jefreyhipp/Dispositivo_de_asistencia_para_personas_con_baja_vision/Ensamble Final/im1.jpg

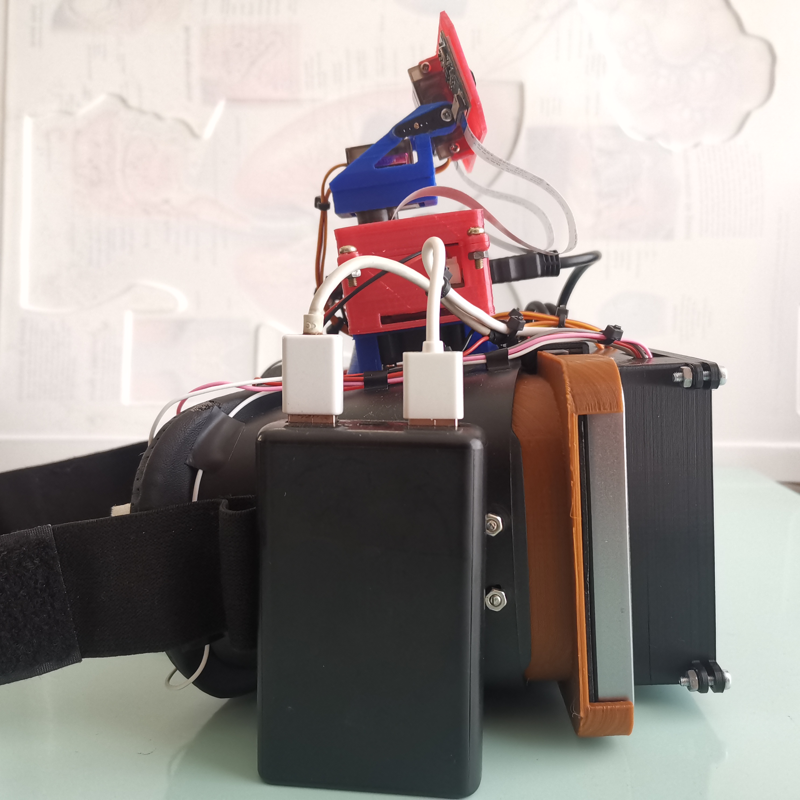
Ensamble Final/im1.jpg
