jefreyhipp/Dispositivo_de_asistencia_para_personas_con_baja_vision/Diseños 3D/Renders/pieza1,2.png

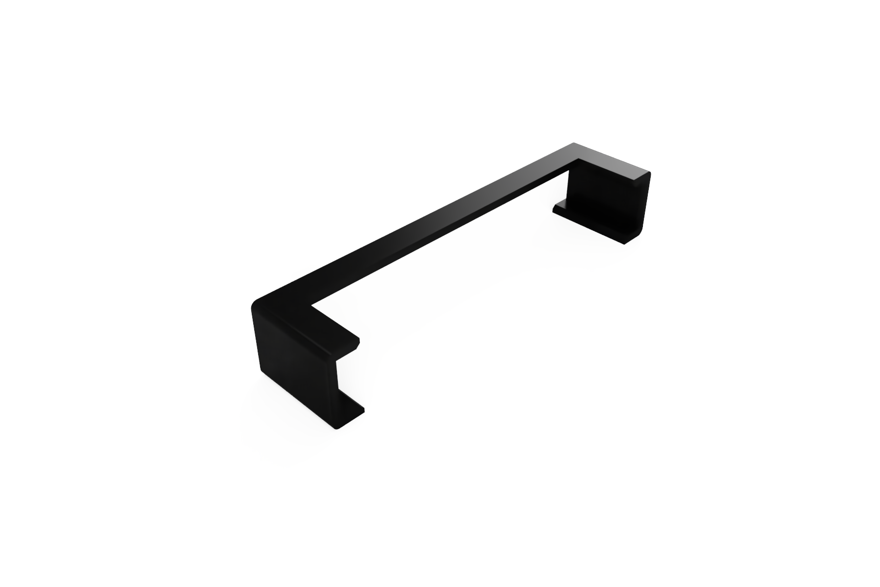
Diseños 3D/Renders/pieza1,2.png
