jefreyhipp/Dispositivo_de_asistencia_para_personas_con_baja_vision/Diseños 3D/Archivos STL/pieza4.stl

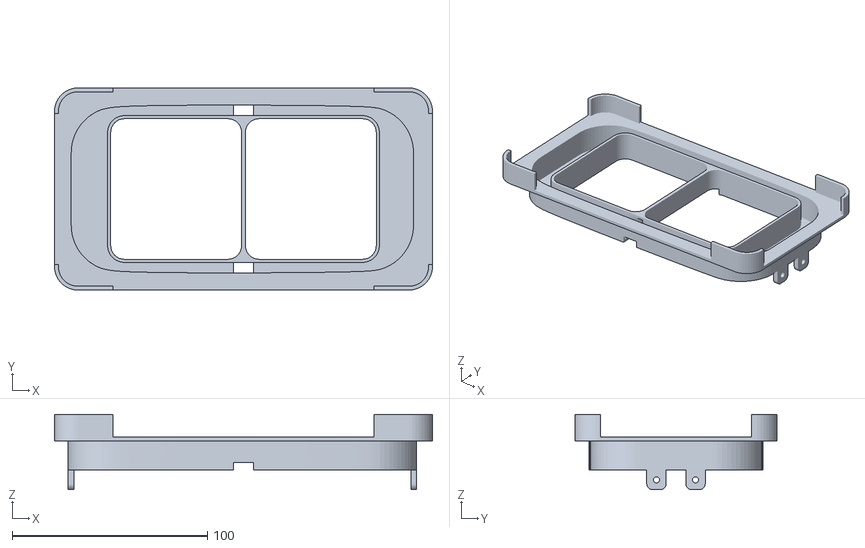
[picture p13: CAD file, 2021-05-15]
Diseños 3D/Archivos STL/pieza4.stl
193.6 x 103.6 x 38.6
