jefreyhipp/Dispositivo_de_asistencia_para_personas_con_baja_vision/Diseños 3D/Archivos STL/pieza6.stl

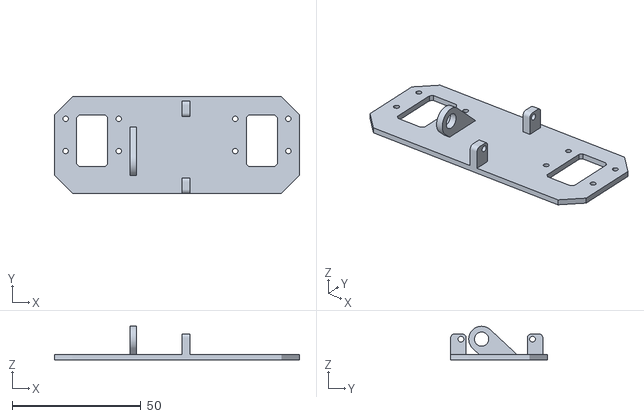
[picture p14: CAD file, 2021-05-15]
Diseños 3D/Archivos STL/pieza6.stl
95.0 x 37.5 x 13.0
