jefreyhipp/Dispositivo_de_asistencia_para_personas_con_baja_vision/Diseños 3D/Archivos STL/pieza10.stl

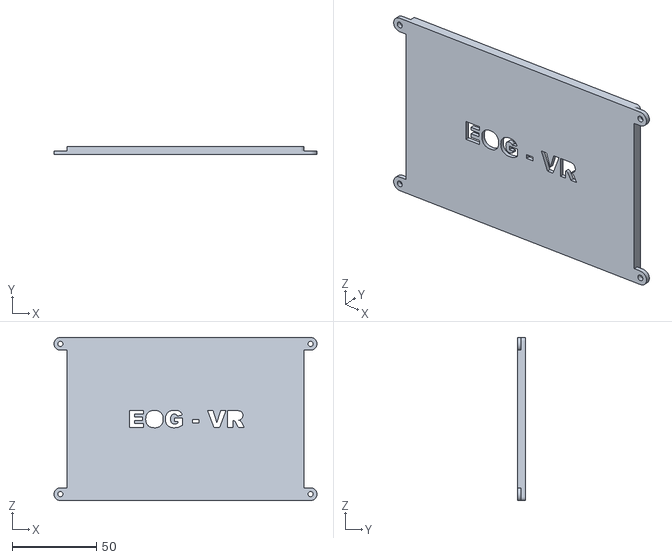
[picture p15: CAD file, 2021-05-15]
Diseños 3D/Archivos STL/pieza10.stl
155.7 x 5.00 x 96.6
