jefreyhipp/Dispositivo_de_asistencia_para_personas_con_baja_vision/Diseños 3D/Archivos STL/pieza9.stl

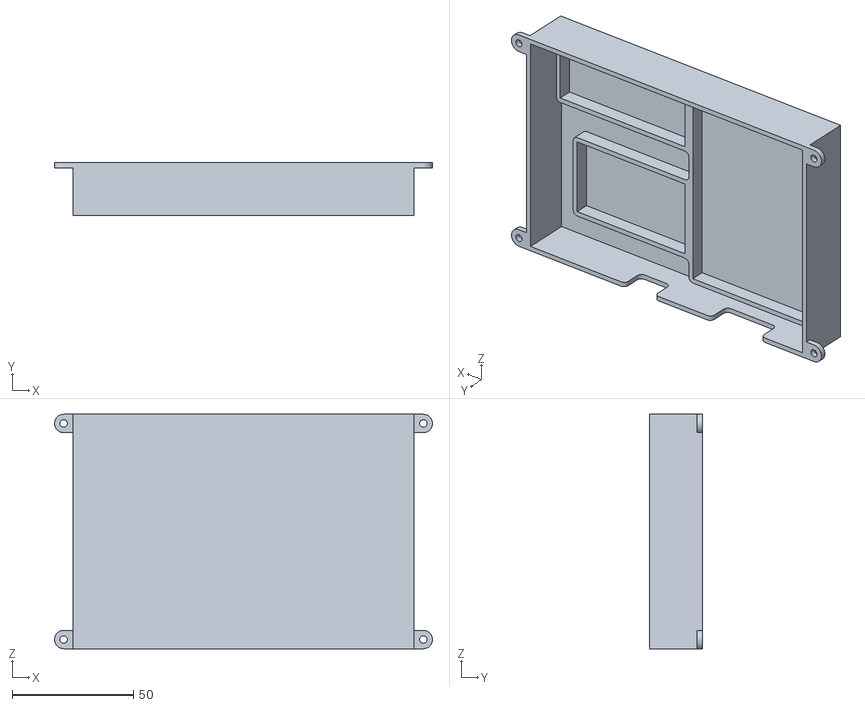
[picture p16: CAD file, 2021-05-15]
Diseños 3D/Archivos STL/pieza9.stl
155.7 x 22.0 x 96.6
