jefreyhipp/Dispositivo_de_asistencia_para_personas_con_baja_vision/Diseños 3D/Archivos STL/pieza5.stl

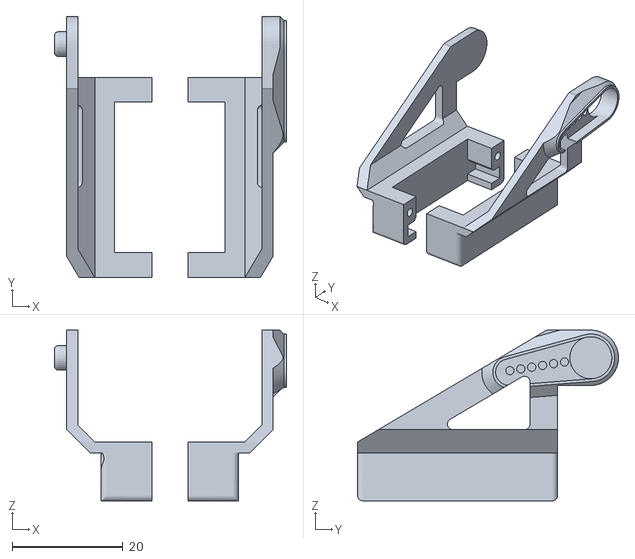
[picture p17: CAD file, 2021-05-15]
Diseños 3D/Archivos STL/pieza5.stl
42.0 x 47.2 x 30.9
