jefreyhipp/Dispositivo_de_asistencia_para_personas_con_baja_vision/Diseños 3D/Archivos STL/pieza7.stl

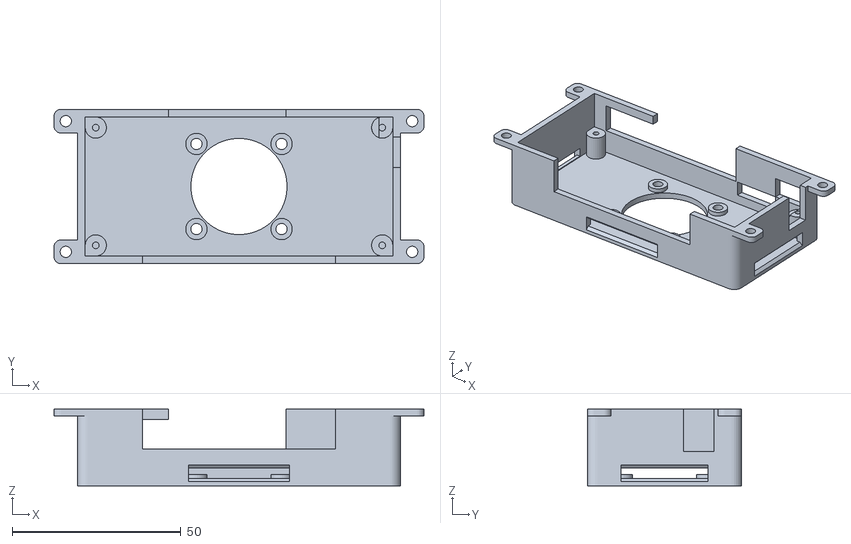
[picture p18: CAD file, 2021-05-15]
Diseños 3D/Archivos STL/pieza7.stl
109.7 x 45.8 x 22.8
