jefreyhipp/Dispositivo_de_asistencia_para_personas_con_baja_vision/Diseños 3D/Archivos STL/pieza8.stl

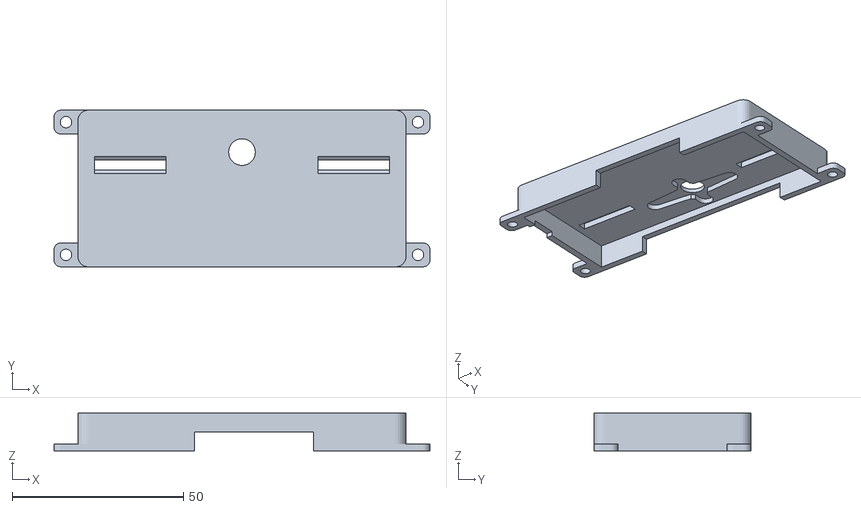
[picture p19: CAD file, 2021-05-15]
Diseños 3D/Archivos STL/pieza8.stl
109.8 x 45.8 x 11.0
