jefreyhipp/Dispositivo_de_asistencia_para_personas_con_baja_vision/Diseños 3D/Archivos STL/pieza1.stl

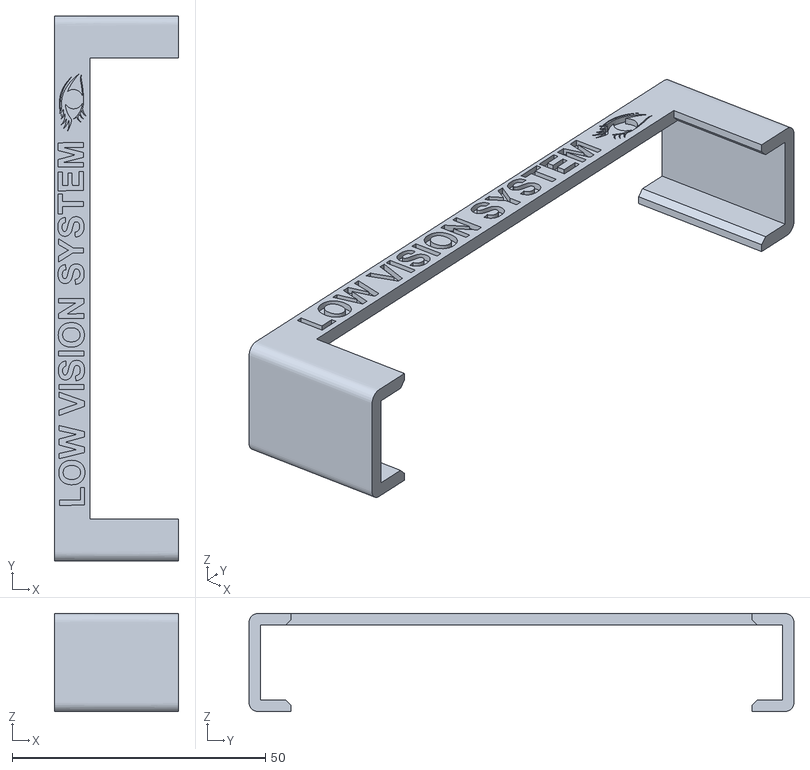
[picture p20: CAD file, 2021-05-15]
Diseños 3D/Archivos STL/pieza1.stl
24.5 x 107.6 x 19.4
