jefreyhipp/Dispositivo_de_asistencia_para_personas_con_baja_vision/Diseños 3D/Archivos STL/pieza3.stl

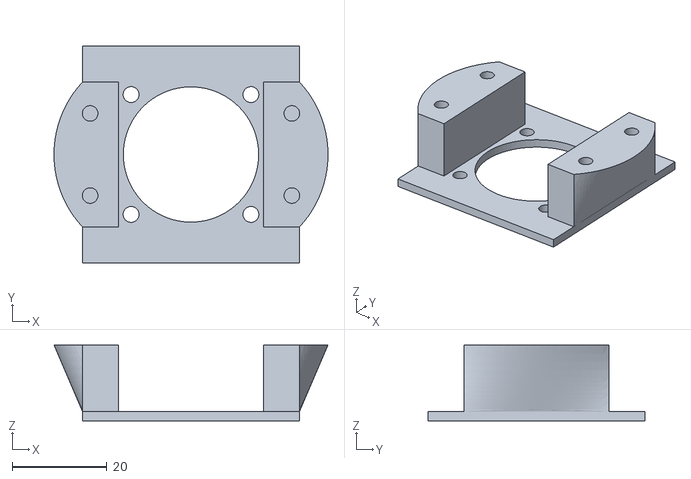
[picture p21: CAD file, 2021-05-15]
Diseños 3D/Archivos STL/pieza3.stl
57.7 x 45.8 x 16.0
