jefreyhipp/Dispositivo_de_asistencia_para_personas_con_baja_vision/Ensamble Final/im2.jpg

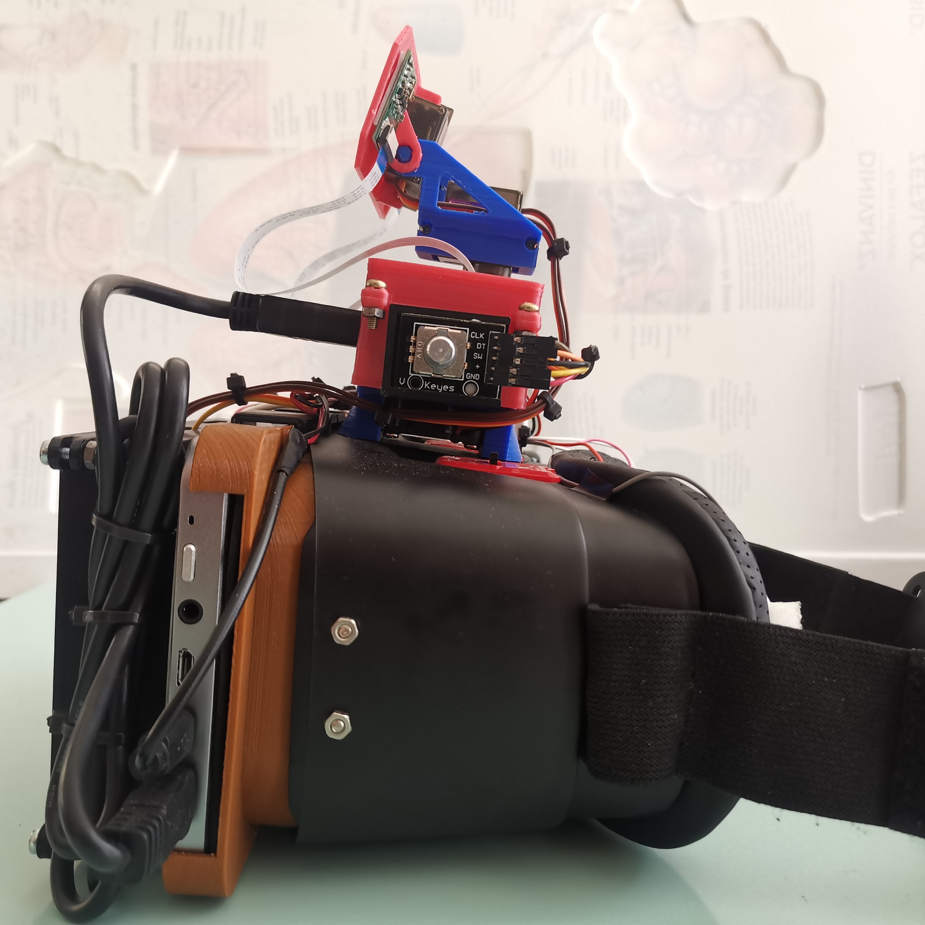
Ensamble Final/im2.jpg
