jefreyhipp/Dispositivo_de_asistencia_para_personas_con_baja_vision/Diseño PCB/Renders/ADS1292_Test_1.png

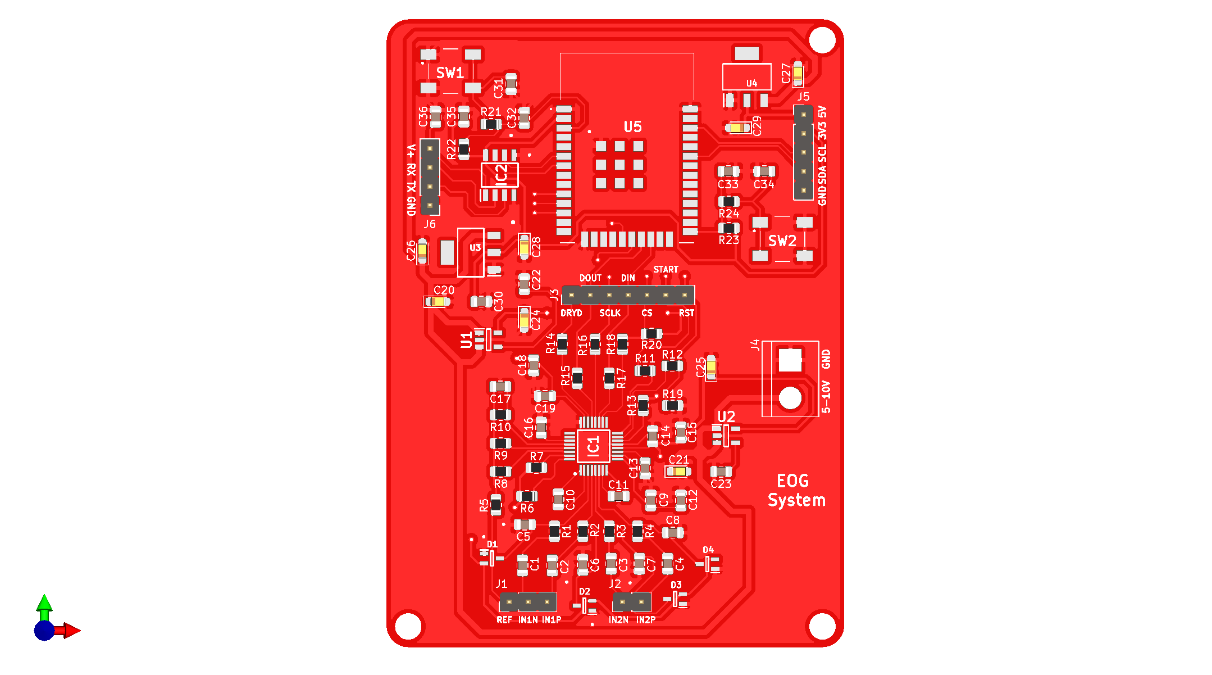
Diseño PCB/Renders/ADS1292_Test_1.png
