jefreyhipp/Dispositivo_de_asistencia_para_personas_con_baja_vision/Diseño PCB/Kicad Files/Esquematicos.pdf

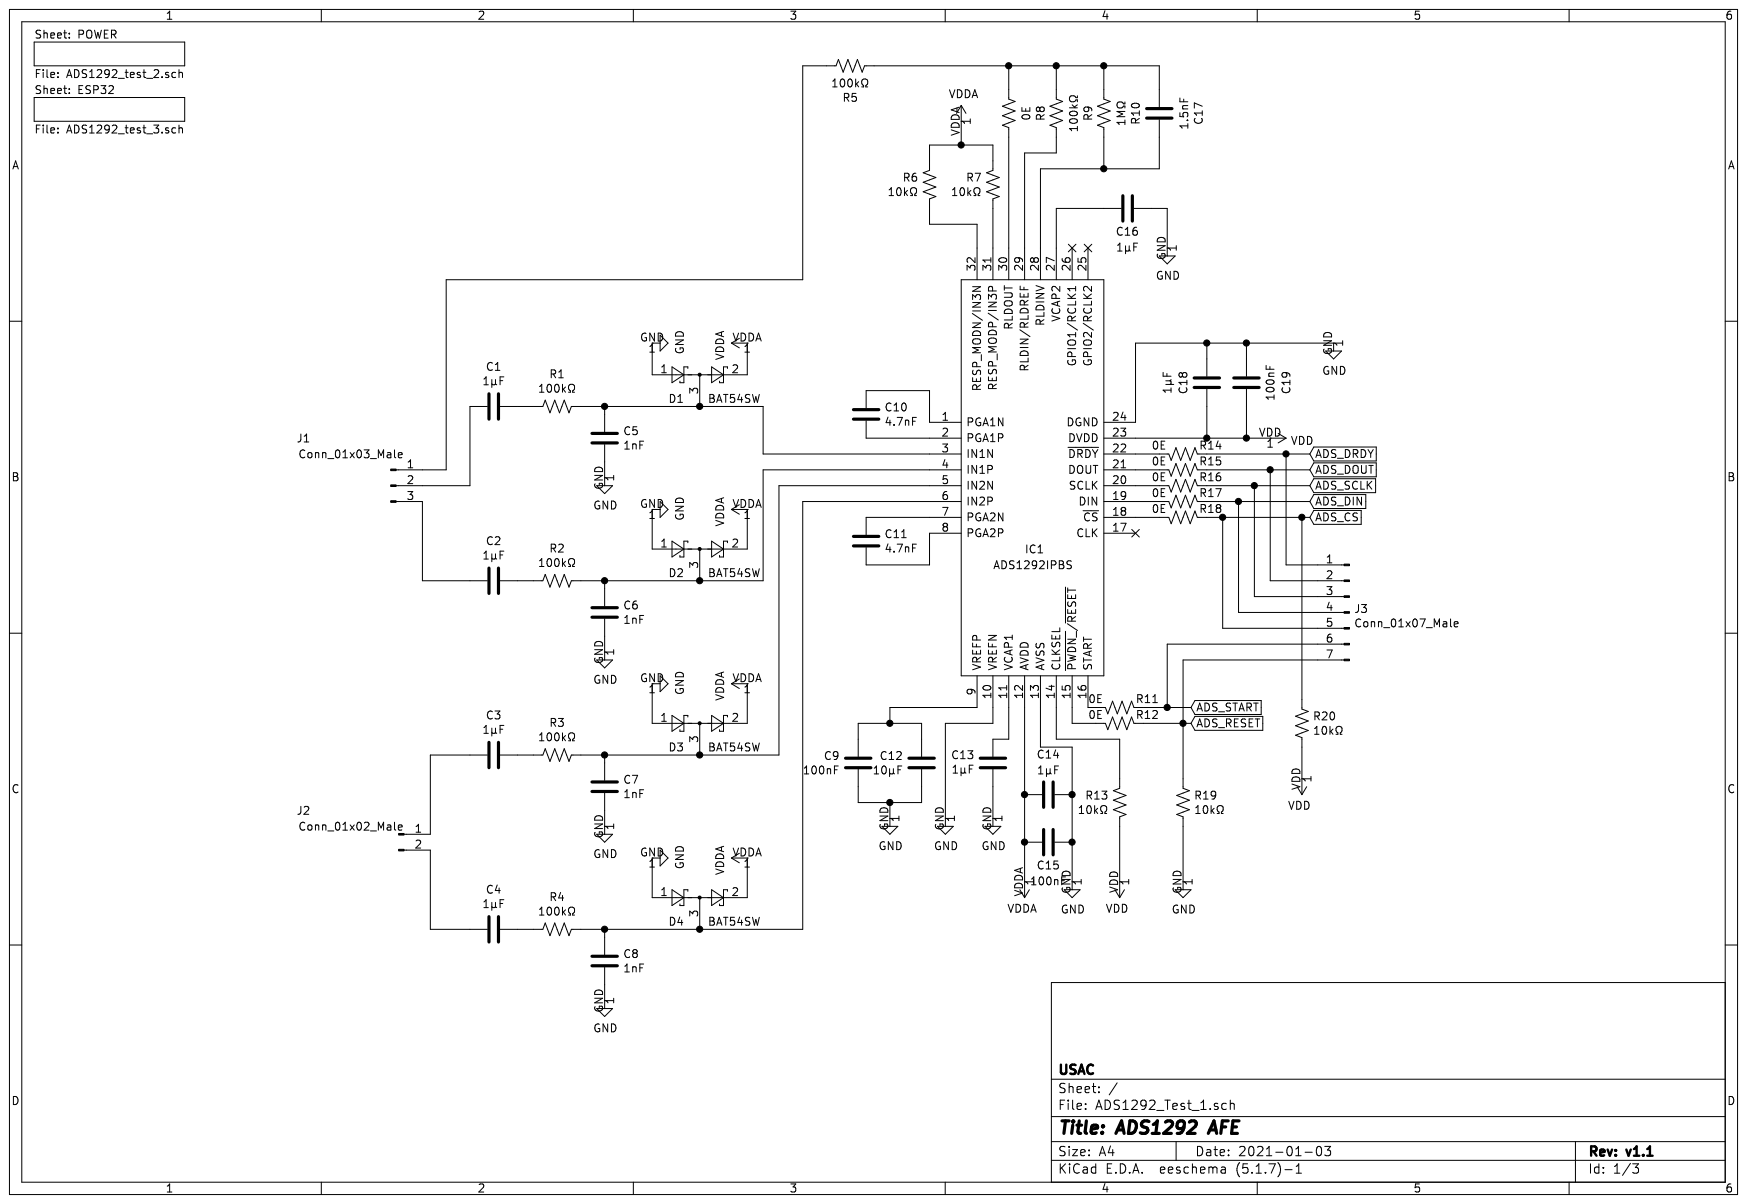
[picture p26: page 1]

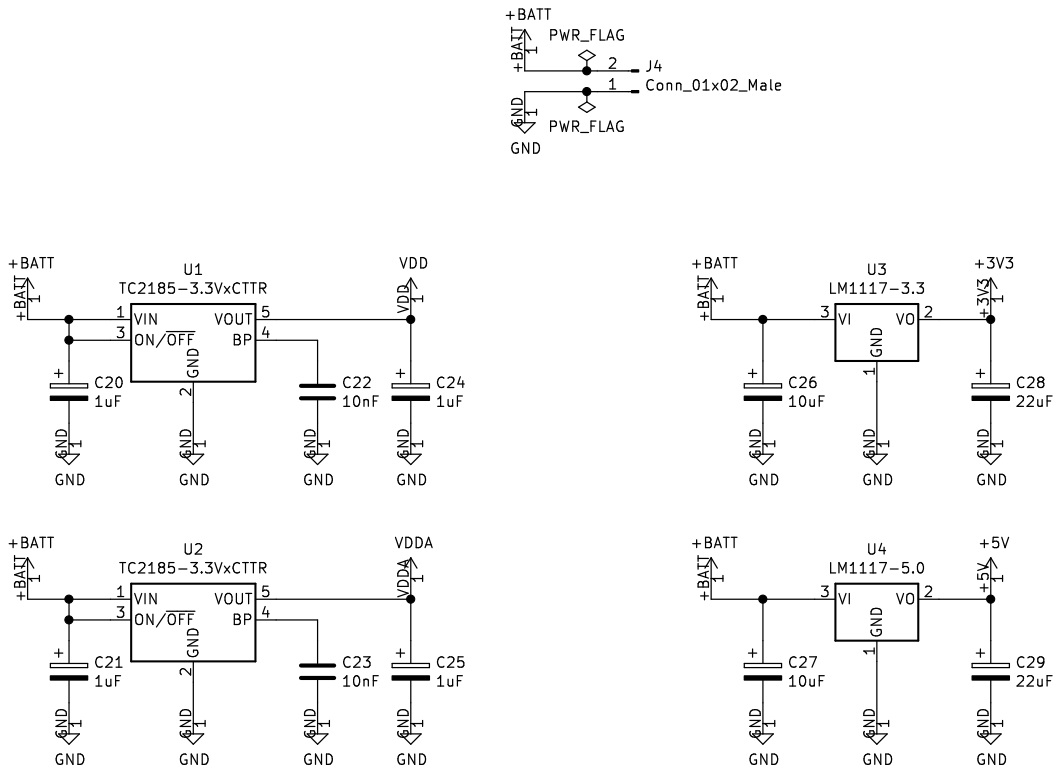
[picture p27: page 2]

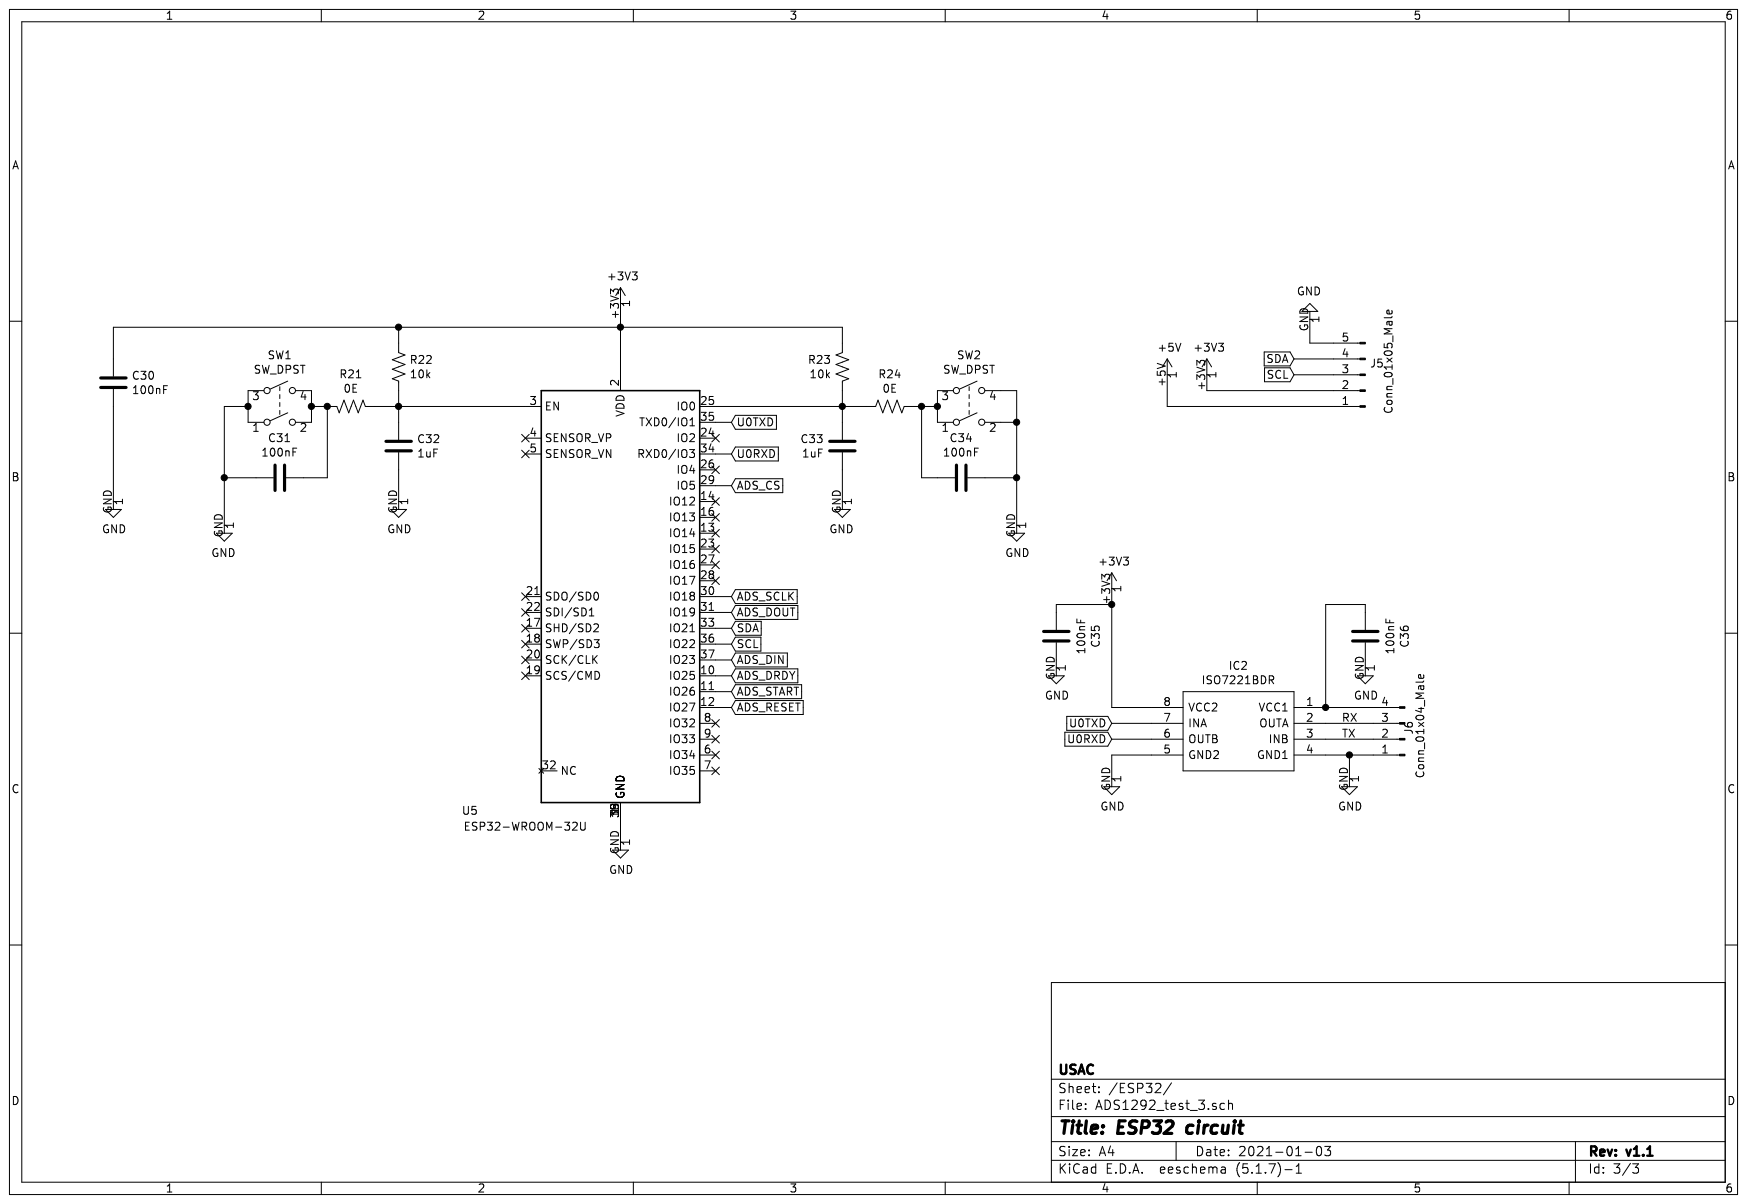
[picture p28: page 3]
