jefreyhipp/Dispositivo_de_asistencia_para_personas_con_baja_vision/Diseño PCB/Kicad Files/ADS1292_Test_1.kicad_pcb

## KiCad design Diseño PCB/Kicad Files/ADS1292_Test_1.kicad_pcb (2021-05-15)

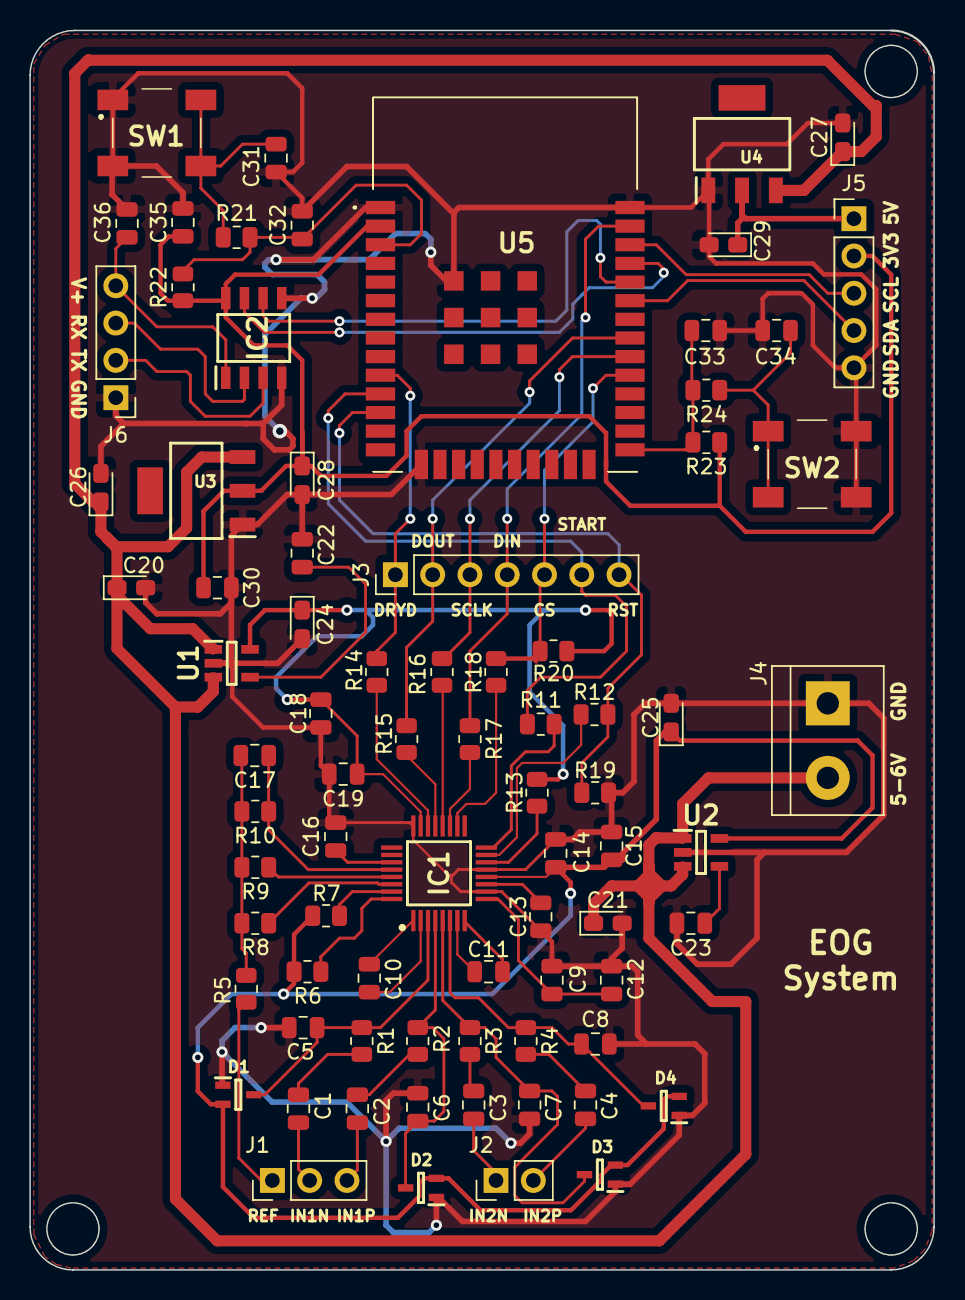
[picture p29: board ADS1292_Test_1.kicad_pcb from above]

Board: 2 copper layers, 61.6 x 84.5 mm, 79 parts (0 on the bottom side), 60 nets.

Parts:
C1, C2, C3, C4, C13, C14, C16, C18: 1µF; C_0805_2012Metric
C5, C6, C7, C8: 1nF; C_0805_2012Metric
C9, C15, C19, C30, C31, C34, C35, C36: 100nF; C_0805_2012Metric
C10, C11: 4.7nF; C_0805_2012Metric
C12: 10µF; C_0805_2012Metric
C17: 1.5nF; C_0805_2012Metric
C20, C21, C24, C25: 1uF; CP_EIA-2012-12_Kemet-R_Pad1.30x1.05mm_HandSolder
C22, C23: 10nF; C_0805_2012Metric
C26, C27: 10uF; CP_EIA-2012-12_Kemet-R_Pad1.30x1.05mm_HandSolder
C28, C29: 22uF; CP_EIA-2012-12_Kemet-R_Pad1.30x1.05mm_HandSolder
C32, C33: 1uF; C_0805_2012Metric
D1, D2, D3, D4: BAT54SW; SOT65P210X110-3N
IC1: ADS1292IPBS; QFP50P700X700X120-32N
IC2: ISO7221BDR; SOIC127P600X175-8N
J1: Conn_01x03_Male; PinHeader_1x03_P2.54mm_Vertical
J2: Conn_01x02_Male; PinHeader_1x02_P2.54mm_Vertical
J3: Conn_01x07_Male; PinHeader_1x07_P2.54mm_Vertical
J4: Conn_01x02_Male; TerminalBlock_bornier-2_P5.08mm
J5: Conn_01x05_Male; PinHeader_1x05_P2.54mm_Vertical
J6: Conn_01x04_Male; PinHeader_1x04_P2.54mm_Vertical
R1, R2, R3, R4, R5, R9: 100kΩ; R_0805_2012Metric
R6, R7, R13, R19, R20: 10kΩ; R_0805_2012Metric
R8, R11, R12, R14, R15, R16, R17, R18, R21, R24: 0E; R_0805_2012Metric
R10: 1MΩ; R_0805_2012Metric
R22, R23: 10k; R_0805_2012Metric
SW1, SW2: SW_DPST; LL3301FF065QJ
U1, U2: TC2185-3.3VxCTTR; SOT95P280X145-5N
U3: LM1117-3.3; SOT230P700X180-4N
U4: LM1117-5.0; SOT230P700X180-4N
U5: ESP32-WROOM-32U; ESP32WROOM32EM113EH3200PH3Q0

Connections:
+3V3: C28.1, C30.1, C35.2, IC2.8, J5.2, R22.1, R23.1, U3.2, U5.2
+5V: C29.1, J5.1, U4.2
+BATT: C20.1, C21.1, C26.1, C27.1, J4.2, U1.1, U1.3, U2.1, U2.3, U3.3, U4.3
/ESP32/RX: IC2.2, J6.3
/ESP32/TX: IC2.3, J6.2
ADS_CS: J3.5, R18.1, R20.1, U5.29
ADS_DIN: J3.4, R17.1, U5.37
ADS_DOUT: J3.2, R15.1, U5.31
ADS_DRDY: J3.1, R14.1, U5.10
ADS_RESET: J3.7, R12.1, R19.1, U5.12
ADS_SCLK: J3.3, R16.1, U5.30
ADS_START: J3.6, R11.1, U5.11
GND: C5.2, C6.2, C7.2, C8.2, C9.2, C12.2, C13.1, C14.1, C15.1, C16.2, C18.2, C19.2, C20.2, C21.2, C22.2, C23.2, C24.2, C25.2, C26.2, C27.2, C28.2, C29.2, C30.2, C31.1, C32.2, C33.2, C34.1, C35.1, C36.1, D1.1, D2.1, D3.1, D4.1, IC1.10, IC1.13, IC1.24, IC2.4, IC2.5, J4.1, J5.5, J6.1, R19.2, SW1.1, SW1.3, SW2.2, SW2.4, U1.2, U2.2, U3.1, U4.1, U5.1, U5.15, U5.38, U5.39
unnamed: C1.1, R1.2
unnamed: C1.2, J1.2
unnamed: C2.1, R2.2
unnamed: C2.2, J1.3
unnamed: C3.1, R3.2
unnamed: C3.2, J2.1
unnamed: C4.1, R4.2
unnamed: C4.2, J2.2
unnamed: C5.1, D1.3, IC1.3, R1.1
unnamed: C6.1, D2.3, IC1.4, R2.1
unnamed: C7.1, D3.3, IC1.5, R3.1
unnamed: C8.1, D4.3, IC1.6, R4.1
unnamed: C10.1, IC1.1
unnamed: C10.2, IC1.2
unnamed: C11.1, IC1.7
unnamed: C11.2, IC1.8
unnamed: C9.1, C12.1, IC1.9
unnamed: C13.2, IC1.11
unnamed: C16.1, IC1.27
unnamed: C17.1, IC1.28, R10.1
unnamed: C17.2, R5.2, R8.2, R9.2, R10.2
unnamed: C22.1, U1.4
unnamed: C23.1, U2.4
unnamed: C31.2, R21.1, SW1.2, SW1.4
unnamed: C32.1, R21.2, R22.2, U5.3
unnamed: C33.1, R23.2, R24.2, U5.25
unnamed: C34.2, R24.1, SW2.1, SW2.3
unnamed: C36.2, IC2.1, J6.4
unnamed: IC1.14, R13.1
unnamed: IC1.15, R12.2
unnamed: IC1.16, R11.2
unnamed: IC1.18, R18.2
unnamed: IC1.19, R17.2
unnamed: IC1.20, R16.2
unnamed: IC1.21, R15.2
unnamed: IC1.22, R14.2
unnamed: IC1.29, R9.1
unnamed: IC1.30, R8.1
unnamed: IC1.31, R7.2
unnamed: IC1.32, R6.2
unnamed: J1.1, R5.1
SCL: J5.3, U5.36
SDA: J5.4, U5.33
U0RXD: IC2.6, U5.34
U0TXD: IC2.7, U5.35
VDD: C18.1, C19.1, C24.1, IC1.23, R13.2, R20.2, U1.5
VDDA: C14.2, C15.2, C25.1, D1.2, D2.2, D3.2, D4.2, IC1.12, R6.1, R7.1, U2.5
